formatc1702/Media-Center-Remote/Photos/RF Transmitter PCB/IMG_2746.jpeg

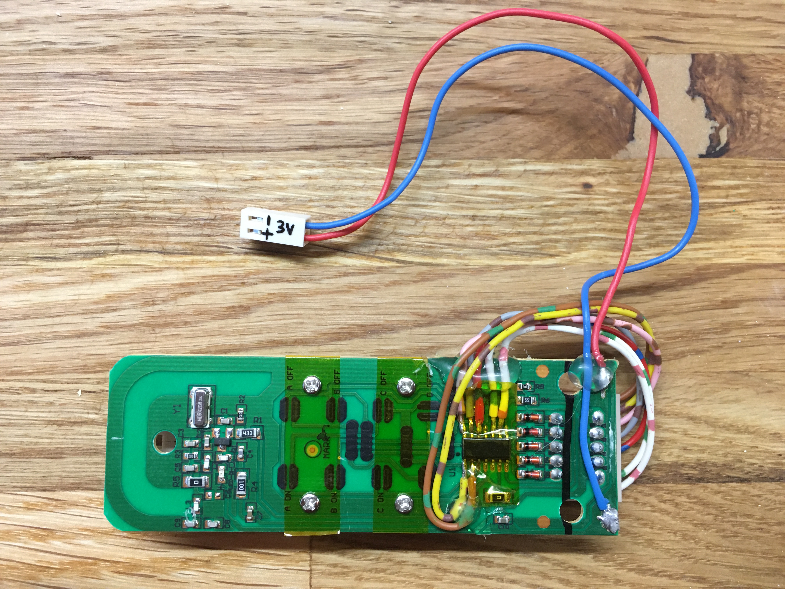
Photos/RF Transmitter PCB/IMG_2746.jpeg
