formatc1702/Media-Center-Remote/Photos/Reverse Engineering/IMG_2761.jpg

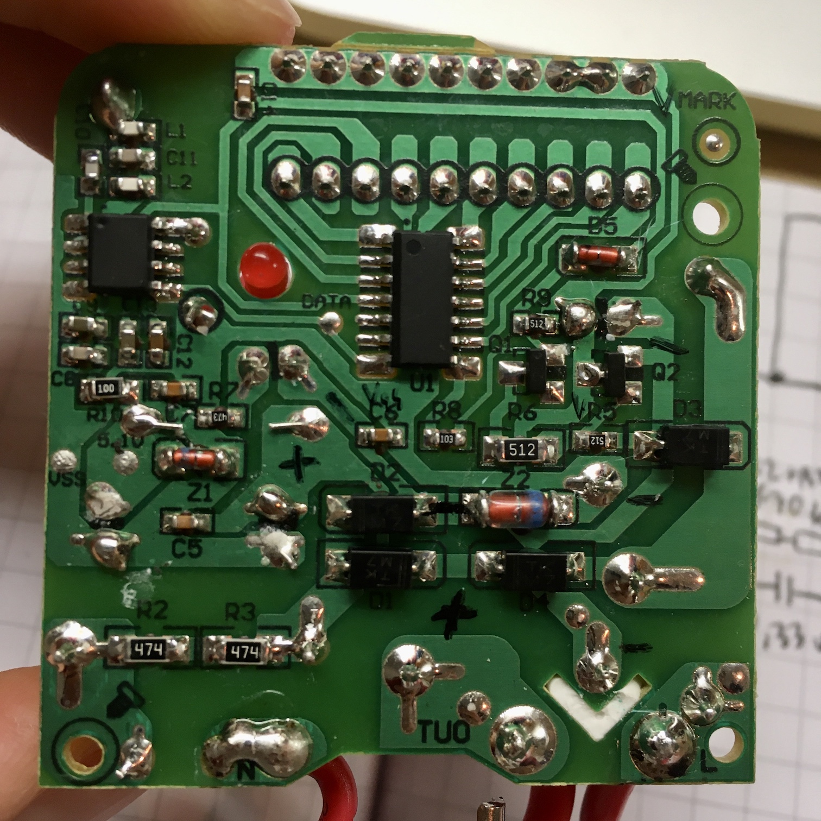
Photos/Reverse Engineering/IMG_2761.jpg
