formatc1702/Media-Center-Remote/Photos/IR Microcontroller PCB/IMG_2748.jpeg

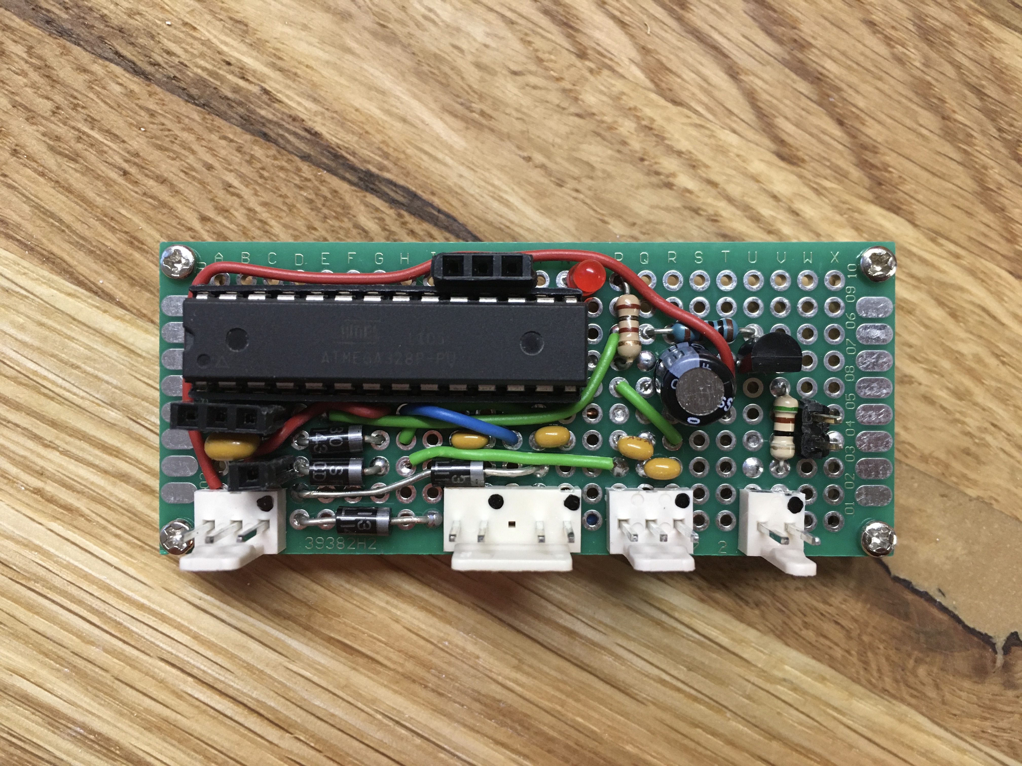
Photos/IR Microcontroller PCB/IMG_2748.jpeg
