formatc1702/Media-Center-Remote/Photos/Reverse Engineering/IMG_2762.jpg

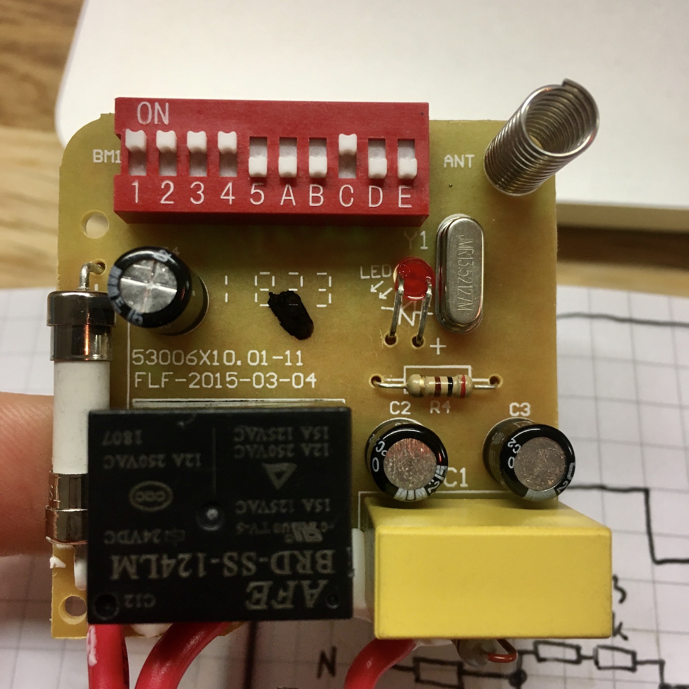
Photos/Reverse Engineering/IMG_2762.jpg
