formatc1702/Media-Center-Remote/Photos/Reverse Engineering/IMG_2764.jpg

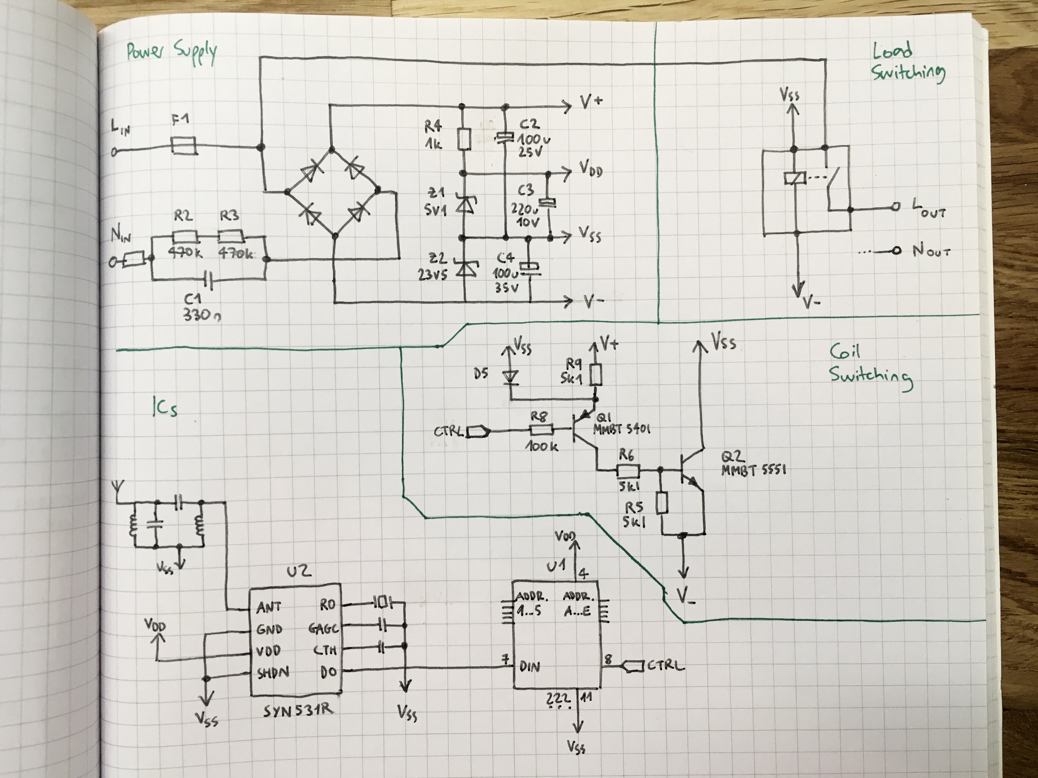
Photos/Reverse Engineering/IMG_2764.jpg
