formatc1702/Media-Center-Remote/Photos/RF Transmitter PCB/IMG_2743.jpeg

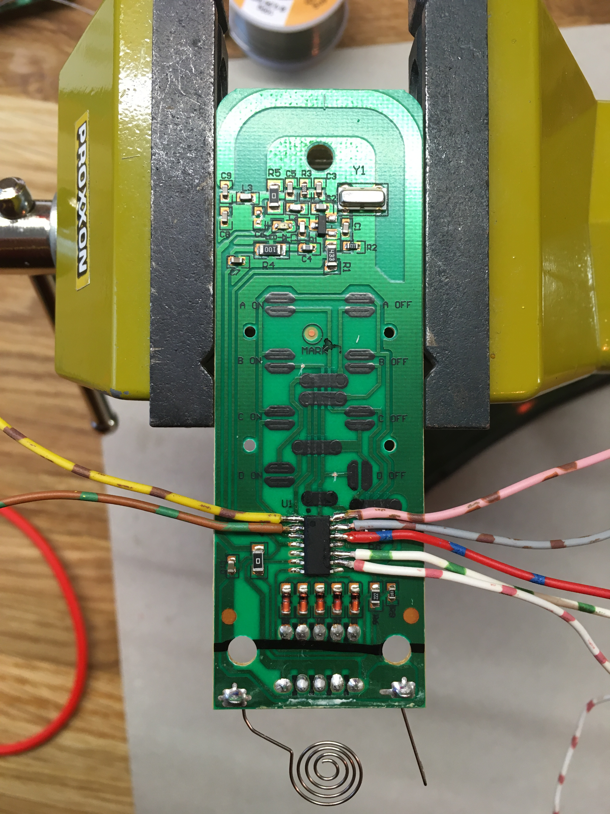
Photos/RF Transmitter PCB/IMG_2743.jpeg
