formatc1702/Media-Center-Remote/Mechanical/MediaTable Mechanical Drawing.pdf

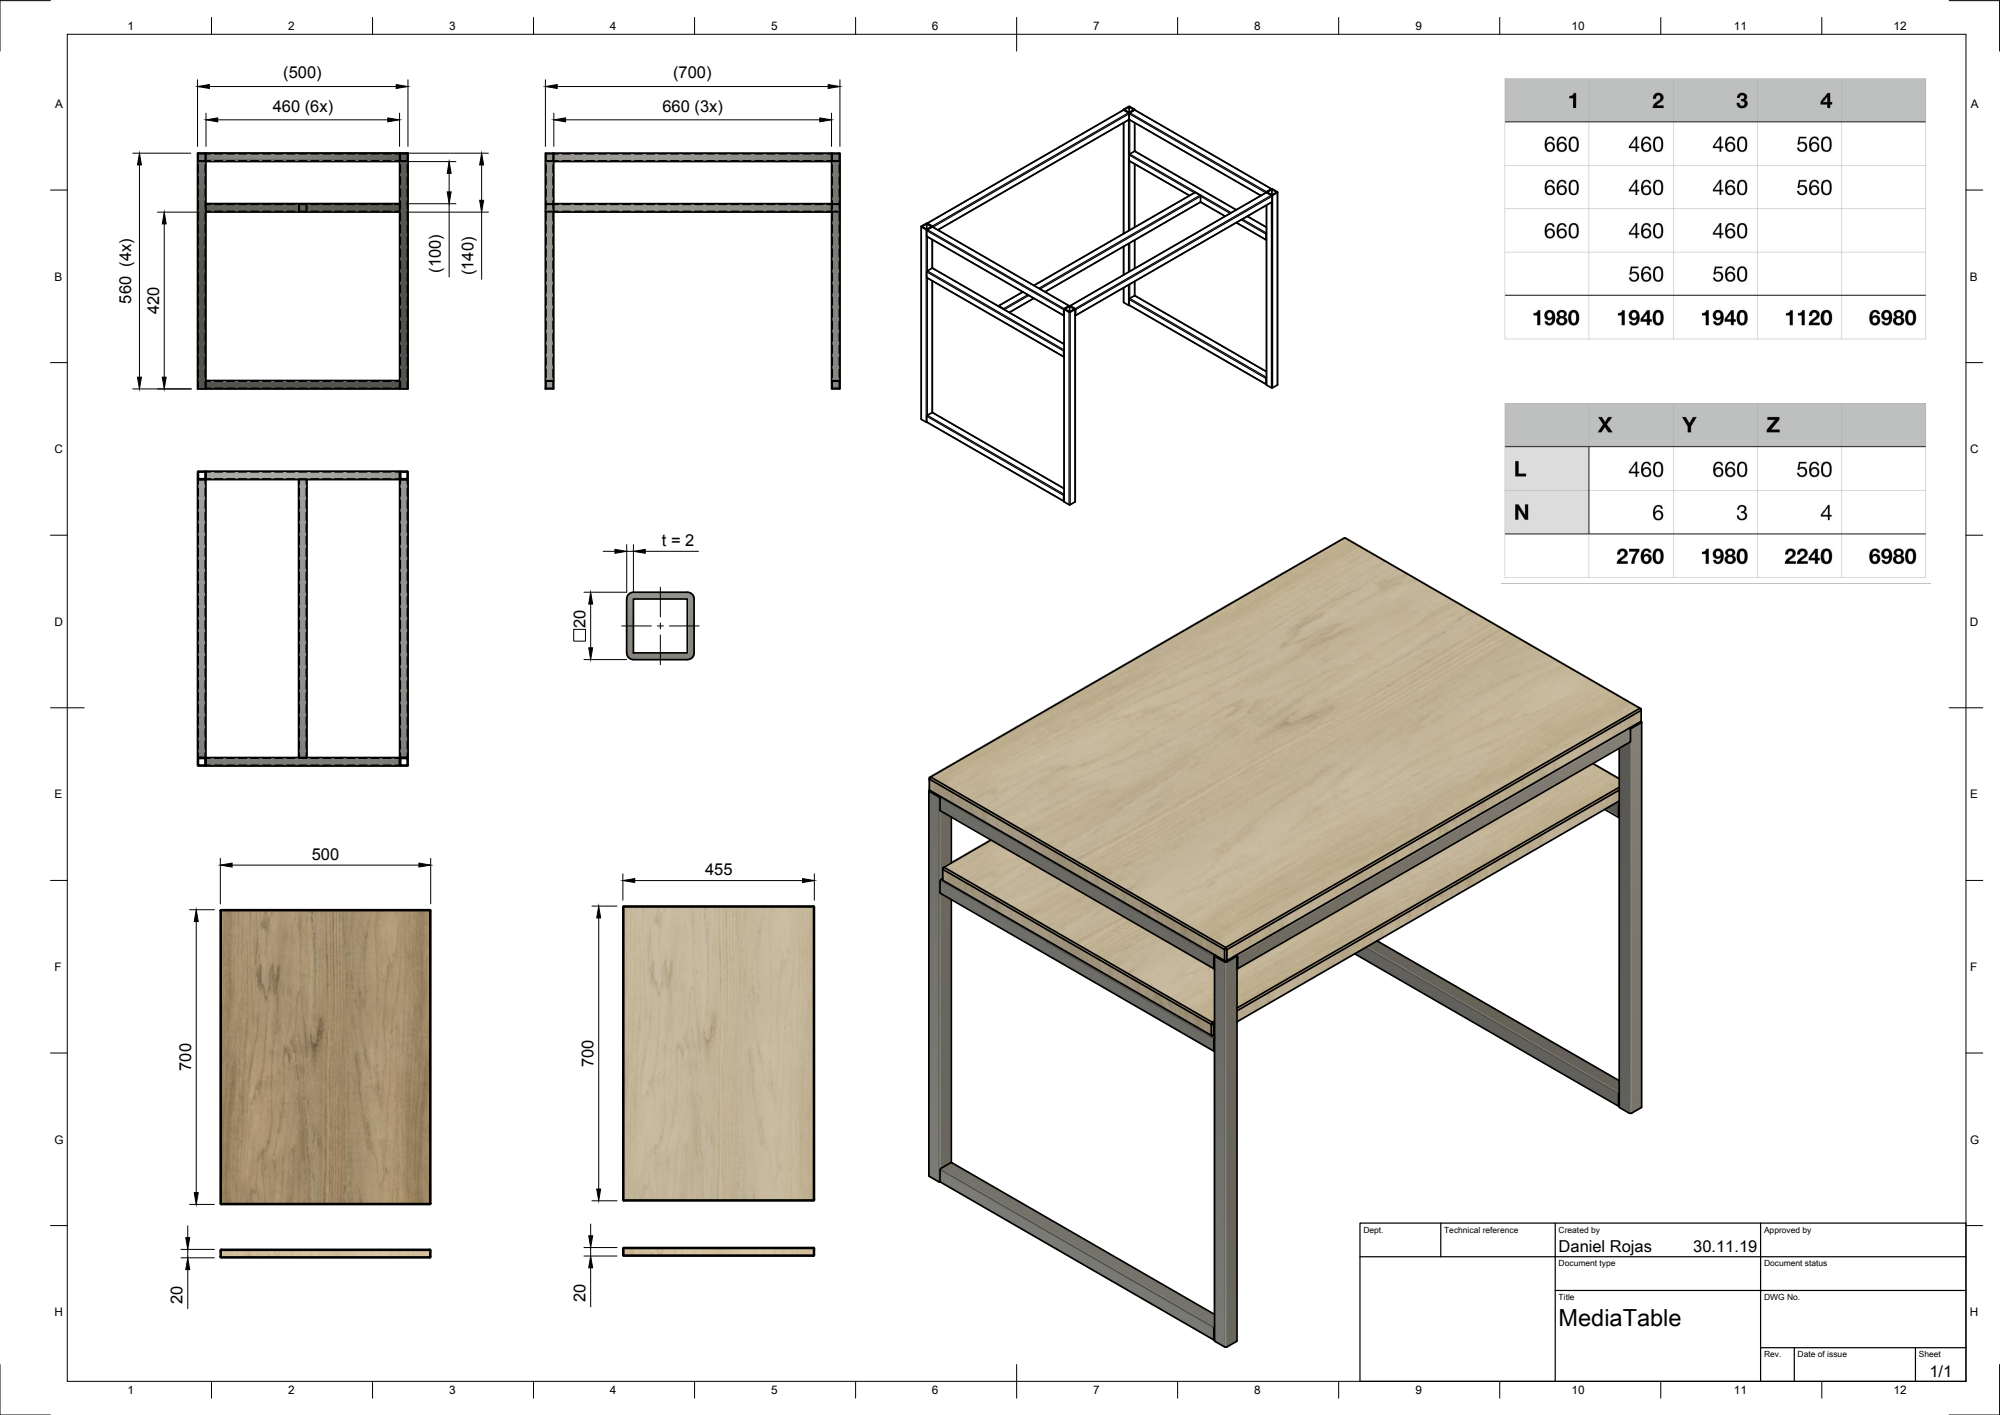
[picture p7: page 1]

Dept. | Technical reference | Created by Daniel Rojas 30.11.19 | Approved by

Document type | Document status

Title MediaTable | DWG No.

Rev. | Date of issue | Sheet 1/1
