formatc1702/Media-Center-Remote/Schematic/mcremote.sch.pdf

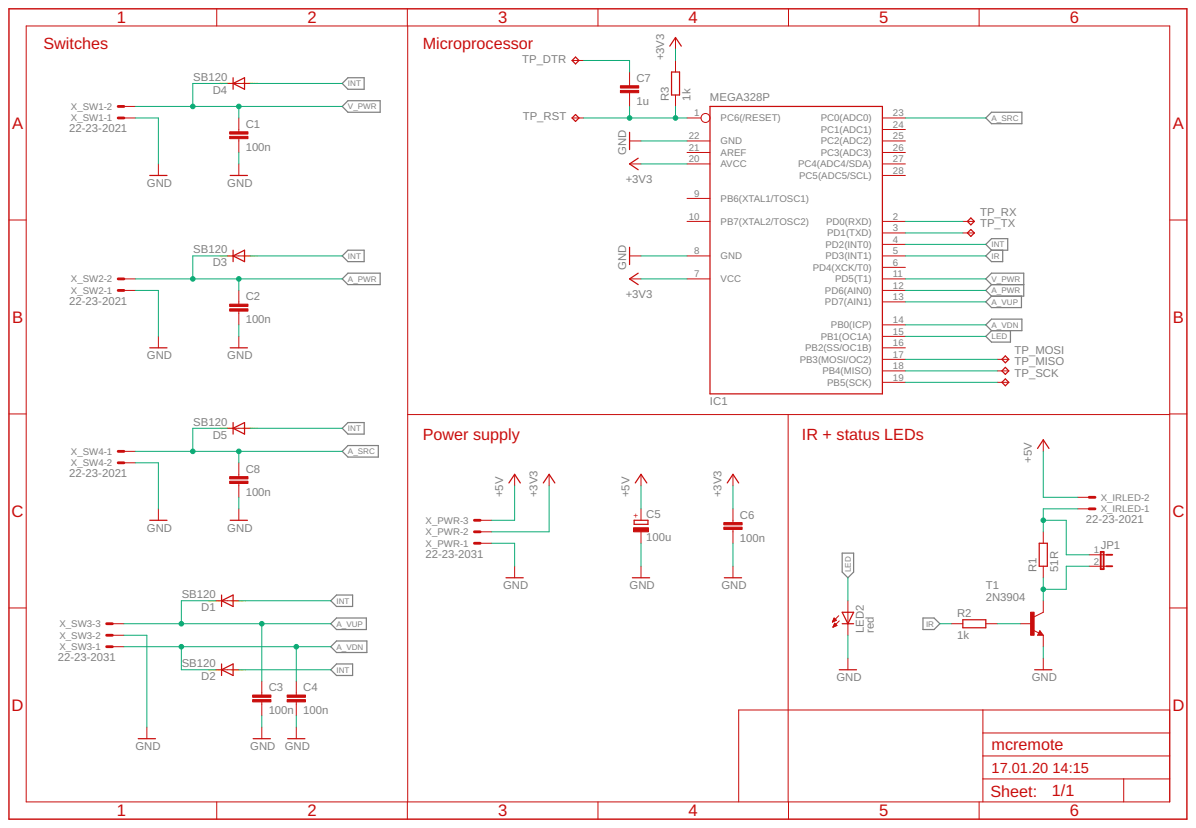
[picture p8: page 1]
