formatc1702/Media-Center-Remote/Schematic/mcremote.brd

## EAGLE design Schematic/mcremote.brd (2020-01-17)

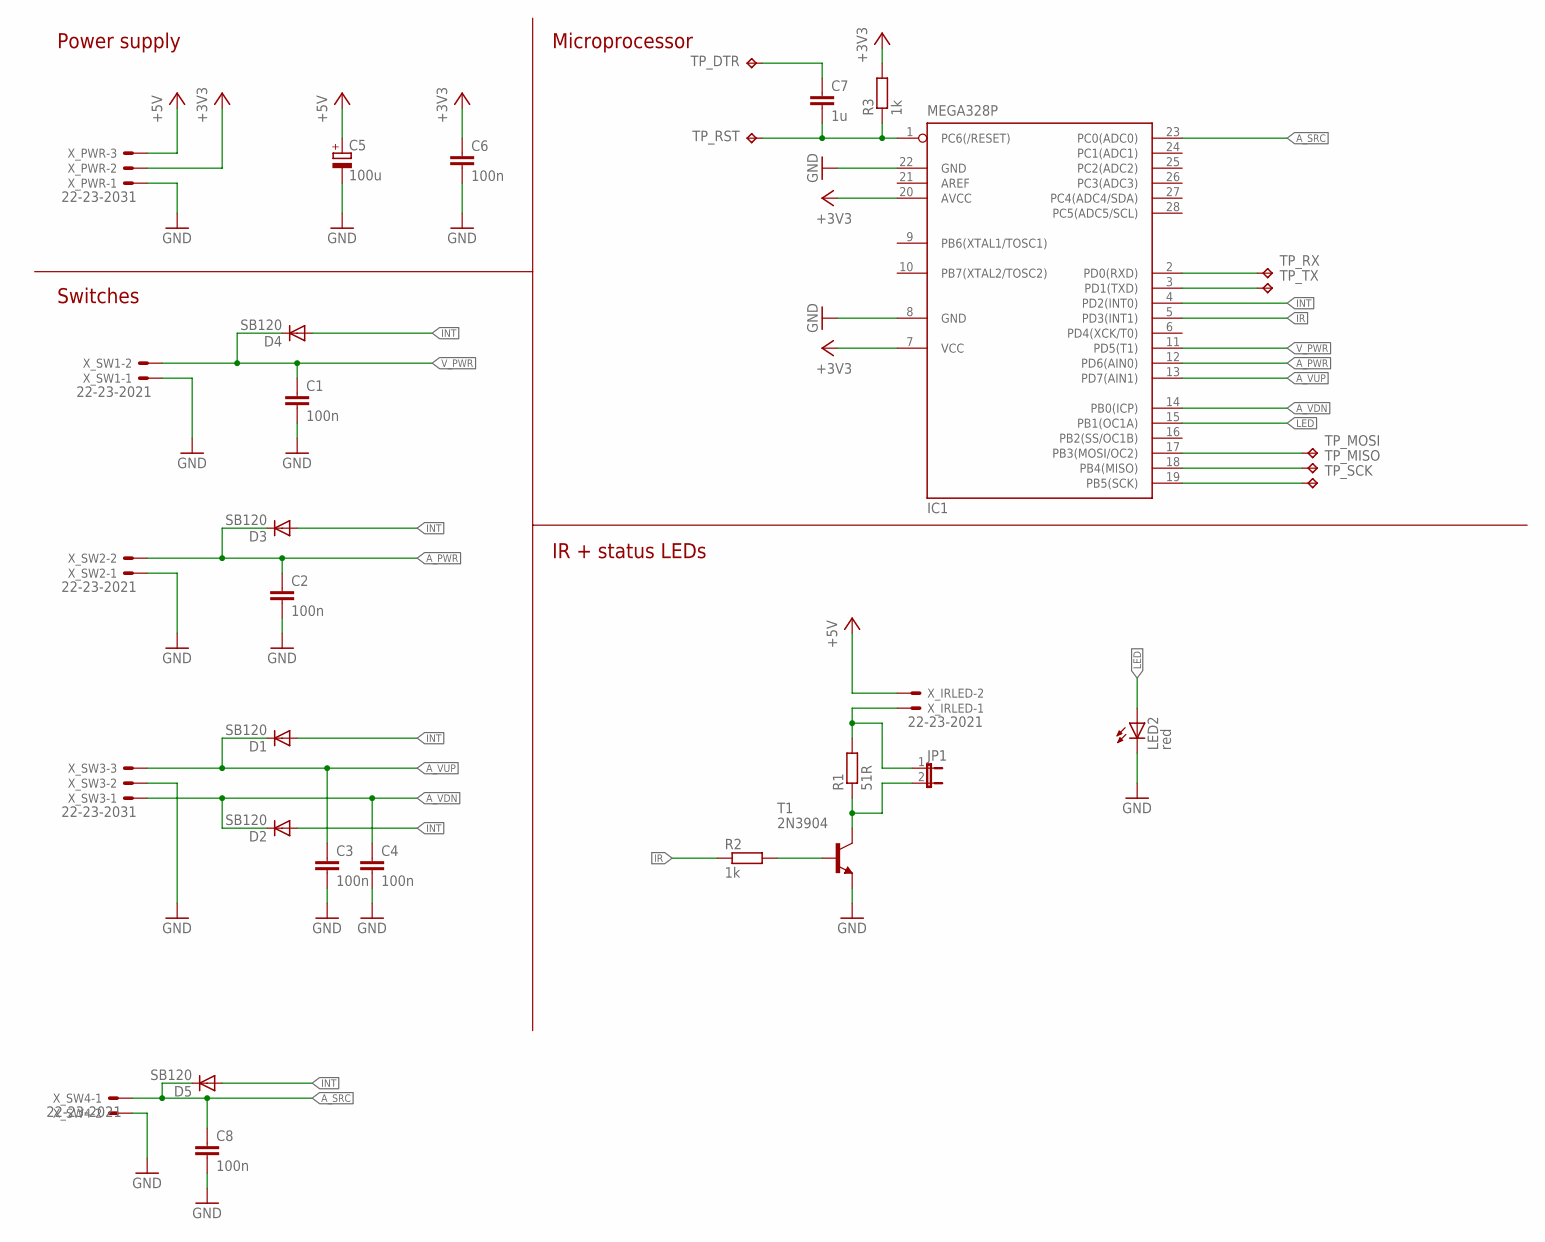
[picture p9: schematic mcremote.sch]

Parts:
C1, C2, C3, C4, C6, C8: 100n; C025-024X044
C5: 100u; E3,5-8
C7: 1u; C025-024X044
D1, D2, D3, D4: SB120; DO41-10
D5: SB120; DO41-7.6
IC1: MEGA328P; DIL28-3
JP1: JP1E; JP1
LED2: red; LED3MM
R1: 51R; 0207/7
R2, R3: 1k; 0207/7
T1: 2N3904; TO92
TP_DTR: TPPAD1-13; P1-13
TP_MISO: TPPAD1-13; P1-13
TP_MOSI: TPPAD1-13; P1-13
TP_RST: TPPAD1-13; P1-13
TP_RX: TPPAD1-13; P1-13
TP_SCK: TPPAD1-13; P1-13
TP_TX: TPPAD1-13; P1-13
X_IRLED: 22-23-2021
X_PWR: 22-23-2031
X_SW1, X_SW2, X_SW4: 22-23-2021
X_SW3: 22-23-2031

Connections:
+3V3: C6.1, IC1.7 (VCC), IC1.20 (AVCC), R3.2, X_PWR.2
+6V: C5.+, X_IRLED.2, X_PWR.3
A_PWR: C2.1, D3.C, IC1.12 (PD6(AIN0)), X_SW2.2
A_SRC: C8.1, D5.C, IC1.23 (PC0(ADC0)), X_SW4.1
A_VDN: C4.1, D2.C, IC1.14 (PB0(ICP)), X_SW3.1
A_VUP: C3.1, D1.C, IC1.13 (PD7(AIN1)), X_SW3.3
GND: C1.2, C2.2, C3.2, C4.2, C5.-, C6.2, C8.2, IC1.8 (GND), IC1.22 (GND), LED2.K (C), T1.3 (E), X_PWR.1, X_SW1.1, X_SW2.1, X_SW3.2, X_SW4.2
INT: D1.A, D2.A, D3.A, D4.A, D5.A, IC1.4 (PD2(INT0))
IR: IC1.5 (PD3(INT1)), R2.1
LED: IC1.15 (PB1(OC1A)), LED2.A
MISO: IC1.18 (PB4(MISO)), TP_MISO.TP
MOSI: IC1.17 (PB3(MOSI/OC2)), TP_MOSI.TP
unnamed: JP1.1, R1.2, X_IRLED.1
unnamed: JP1.2, R1.1, T1.1 (C)
unnamed: R2.2, T1.2 (B)
unnamed: C7.2, IC1.1 (PC6(/RESET)), R3.1, TP_RST.TP
unnamed: C7.1, TP_DTR.TP
RX: IC1.2 (PD0(RXD)), TP_RX.TP
SCK: IC1.19 (PB5(SCK)), TP_SCK.TP
TX: IC1.3 (PD1(TXD)), TP_TX.TP
V_PWR: C1.1, D4.C, IC1.11 (PD5(T1)), X_SW1.2

Notes on the sheet:
Power supply
Switches
Microprocessor
IR + status LEDs

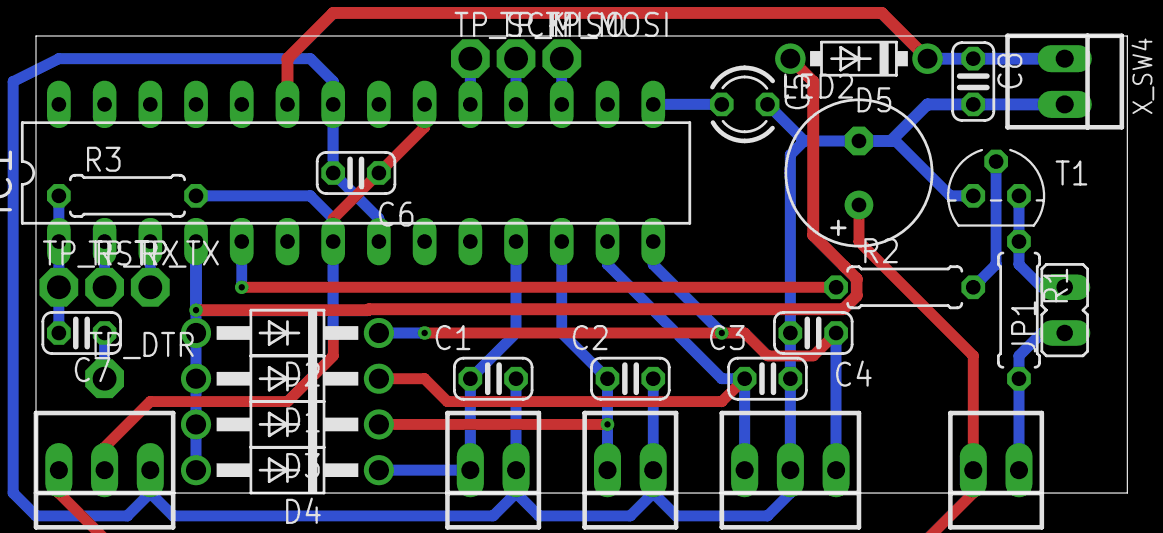
[picture p10: board mcremote.brd from above]

Board: 2 copper layers, 60.6 x 25.4 mm, 33 parts (0 on the bottom side), 21 nets.
