formatc1702/Media-Center-Remote/(commit log)

2019-07-14 Initial Arduino Project with IRemote library
2019-07-14 Revert "Working demo for BenQ projector too"
    This reverts commit d0dc442eba0bf6380bc7d5ecb4ff7ad0d7fe5f36.
    [main.cpp]
2019-08-09 Four buttons + sleep working
2019-08-29 Change UC CPU speed
    Using old Arduino Pro Mini with internal 8 MHz oscillator now
2019-09-28 Use RocketScream Low-Power library
2019-11-24 Add PCB design, adjust pins in firmware
    [mcremote.brd, mcremote.sch]
2020-01-17 Add audio source select button to schematic + PCB
    [mcremote.brd, mcremote.sch]
2020-01-17 Add audio source select button in firmware
2020-01-17 Rearrange schematic
    [mcremote.sch]
2020-05-11 Add schematic PDF
